zqarkop/NDTControllerAndMonitoring/Image on PDF/Gambar 2.1 Ilustrasi Prinsip Kerja Sensor ECT.png

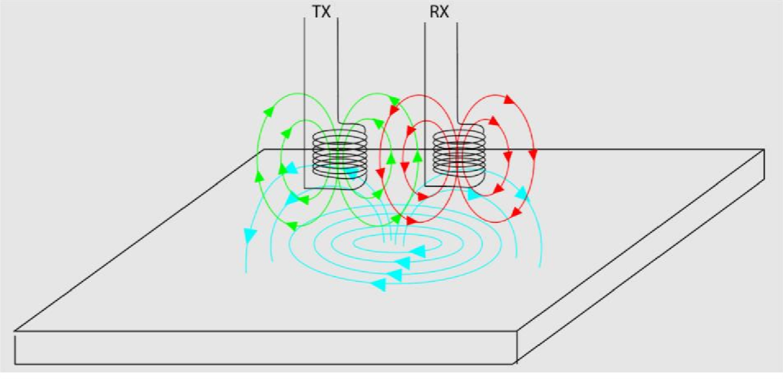
Image on PDF/Gambar 2.1 Ilustrasi Prinsip Kerja Sensor ECT.png
