zqarkop/NDTControllerAndMonitoring/Image on PDF/Gambar 2.2 Ilustrasi Arus Eddy Terhadap Crack.png

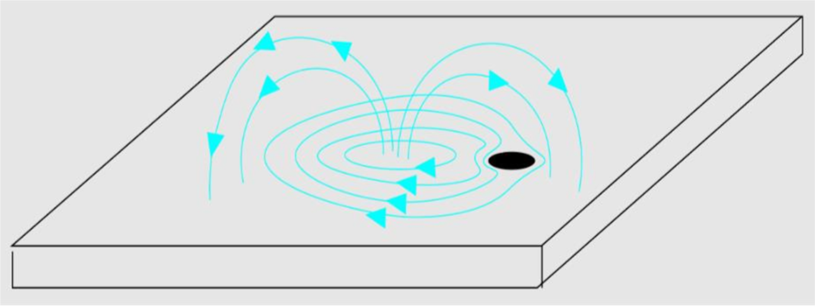
Image on PDF/Gambar 2.2 Ilustrasi Arus Eddy Terhadap Crack.png
