zqarkop/NDTControllerAndMonitoring/Image on PDF/Gambar 2.3 Jenis Filter .png

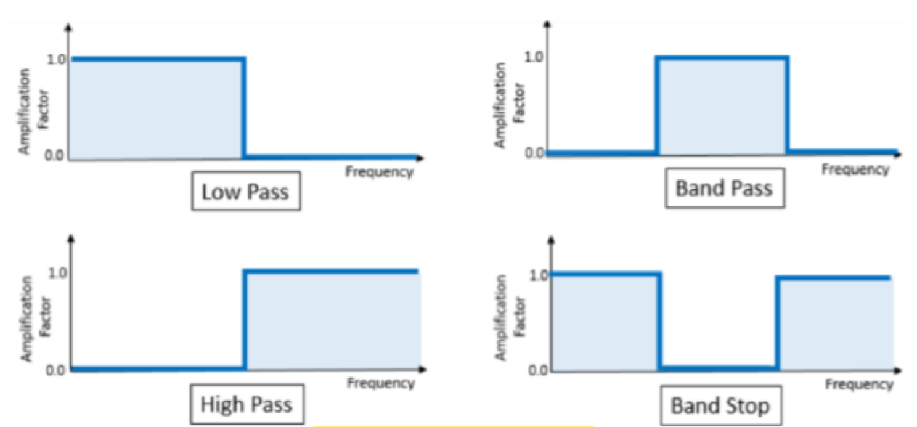
Image on PDF/Gambar 2.3 Jenis Filter .png
