zqarkop/NDTControllerAndMonitoring/Image on PDF/Gambar 2.4 Frequency Response Low Pass Filter .png

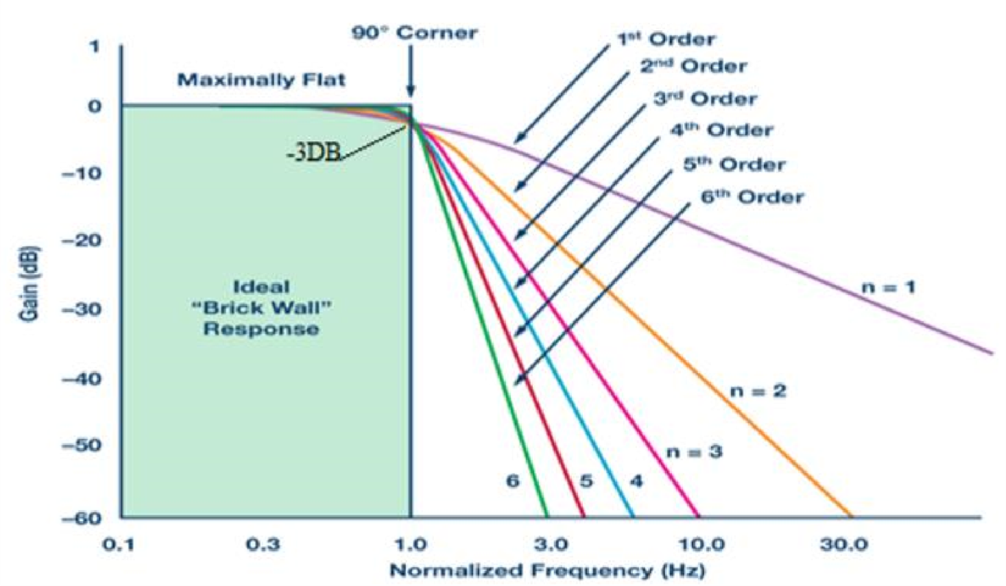
Image on PDF/Gambar 2.4 Frequency Response Low Pass Filter .png
