zqarkop/NDTControllerAndMonitoring/Image on PDF/Gambar 2.5 Topology Sallen Key Filter .png

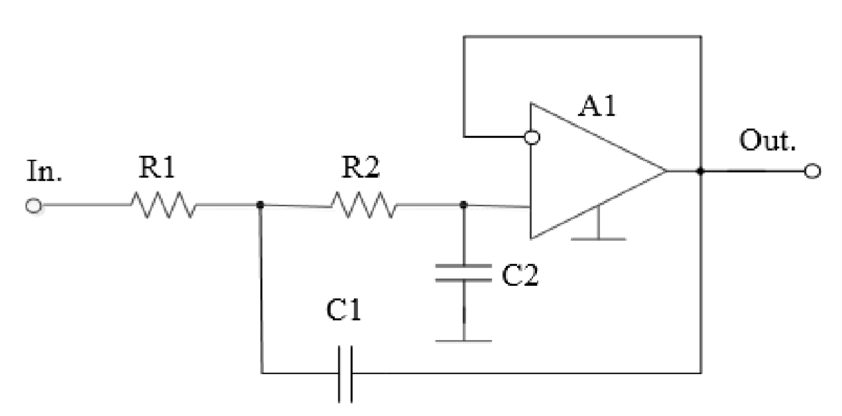
Image on PDF/Gambar 2.5 Topology Sallen Key Filter .png
