zqarkop/NDTControllerAndMonitoring/Image on PDF/Gambar 2.6 Rangkaian Non-Inverting Amplifier .png

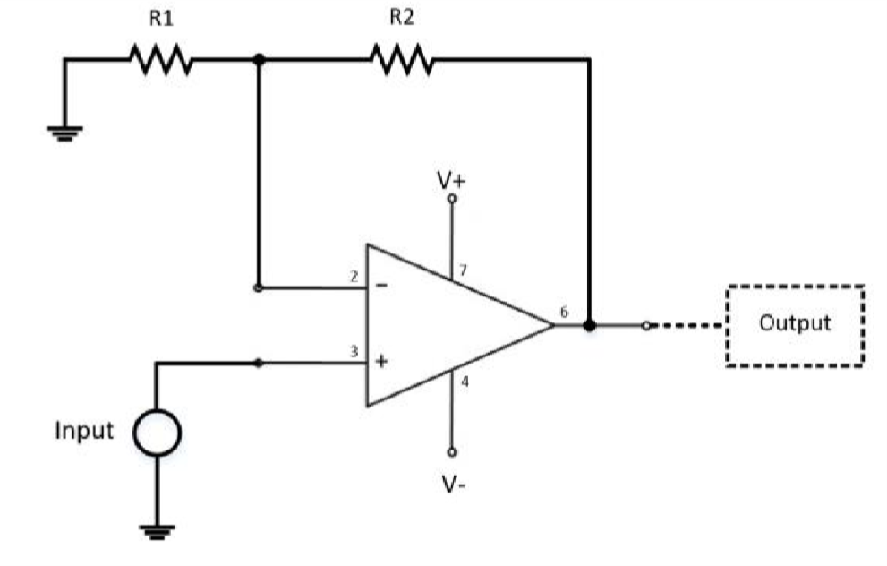
Image on PDF/Gambar 2.6 Rangkaian Non-Inverting Amplifier .png
