zqarkop/NDTControllerAndMonitoring/Image on PDF/Gambar 2.7 Rangkaian Stepper Motor.png

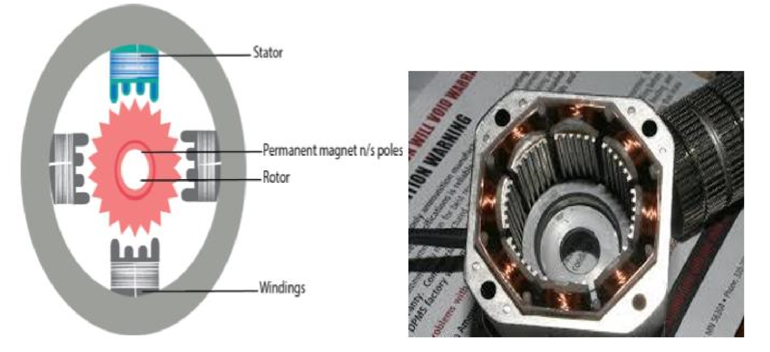
Image on PDF/Gambar 2.7 Rangkaian Stepper Motor.png
