zqarkop/NDTControllerAndMonitoring/Image on PDF/Gambar 3.2 Diagram Skematik Signal Generator Mini .png

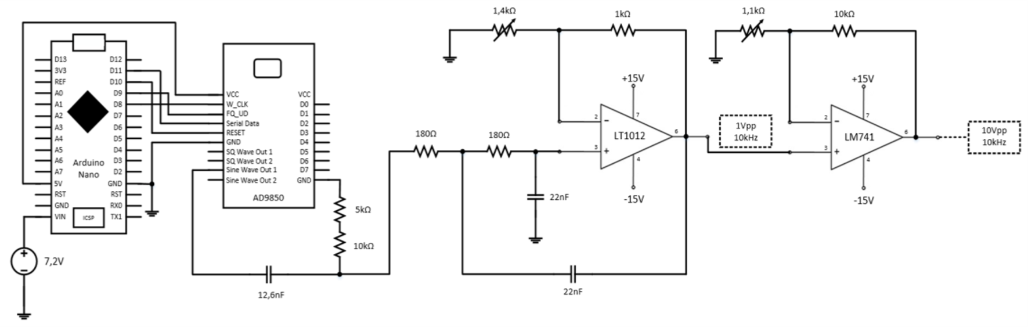
Image on PDF/Gambar 3.2 Diagram Skematik Signal Generator Mini .png
