zqarkop/NDTControllerAndMonitoring/Image on PDF/Gambar 4.2 Keluaran Signal Generator Sine Wave .png

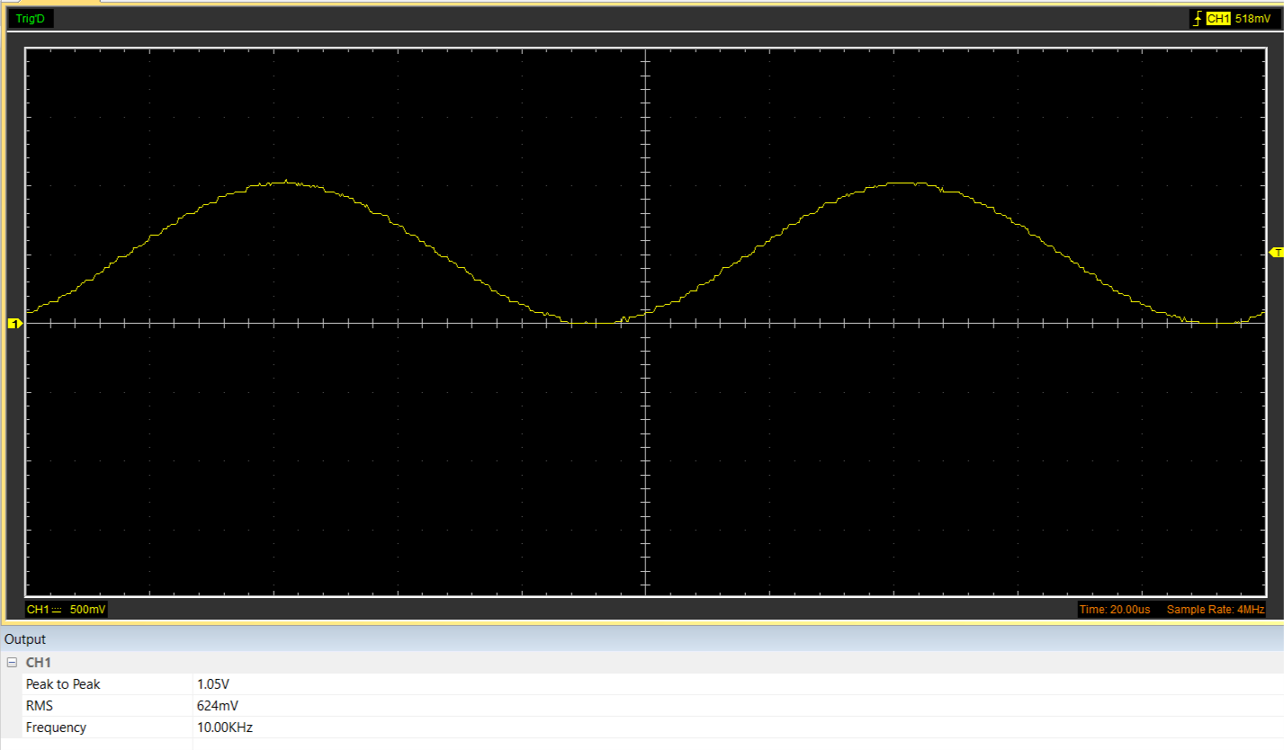
Image on PDF/Gambar 4.2 Keluaran Signal Generator Sine Wave .png
