zqarkop/NDTControllerAndMonitoring/Image on PDF/Gambar 4.4 Diagram Bode HPF dengan Fc 842Hz .png

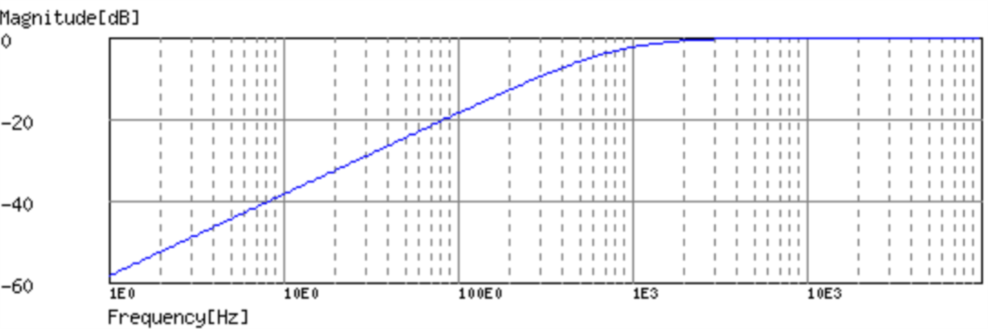
Image on PDF/Gambar 4.4 Diagram Bode HPF dengan Fc 842Hz .png
