zqarkop/NDTControllerAndMonitoring/Image on PDF/Gambar 4.5 Keluaran Signal Generator Setelah Diberi HPF .png

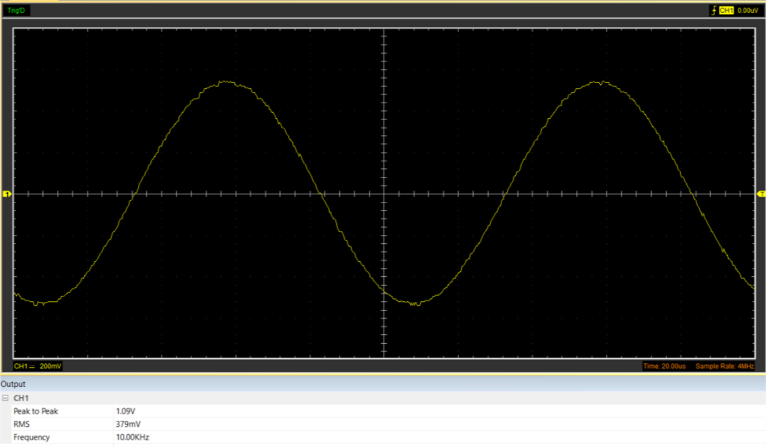
Image on PDF/Gambar 4.5 Keluaran Signal Generator Setelah Diberi HPF .png
