zqarkop/NDTControllerAndMonitoring/Image on PDF/Gambar 4.6 Rangkaian Signal Generator dengan HPF Dan LPF .png

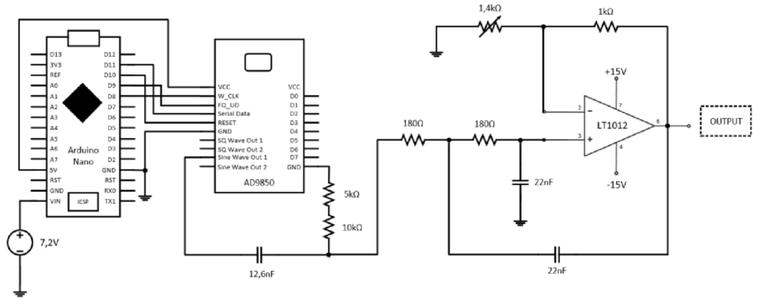
Image on PDF/Gambar 4.6 Rangkaian Signal Generator dengan HPF Dan LPF .png
