zqarkop/NDTControllerAndMonitoring/Image on PDF/Gambar 4.7 Diagram Bode LPF dengan Fc 40,19kHz .png

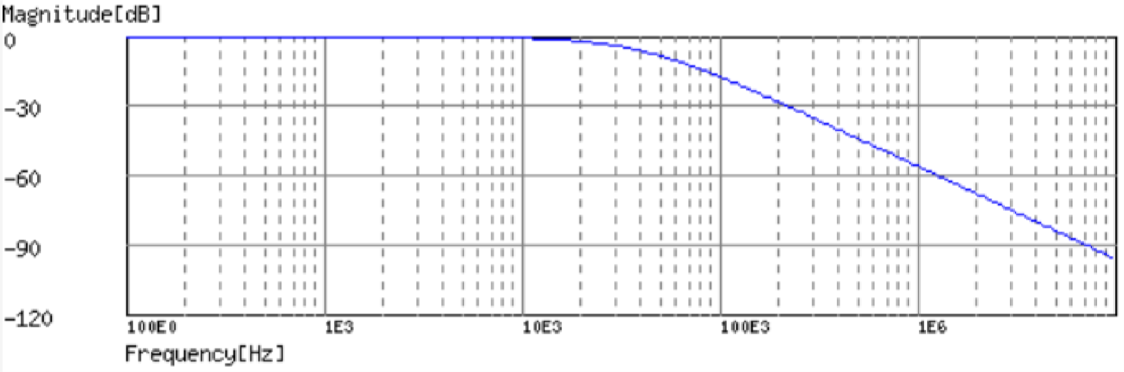
Image on PDF/Gambar 4.7 Diagram Bode LPF dengan Fc 40,19kHz .png
