zqarkop/NDTControllerAndMonitoring/Image on PDF/Gambar 4.9 Keluaran Signal Generator dengan IC LM74.png

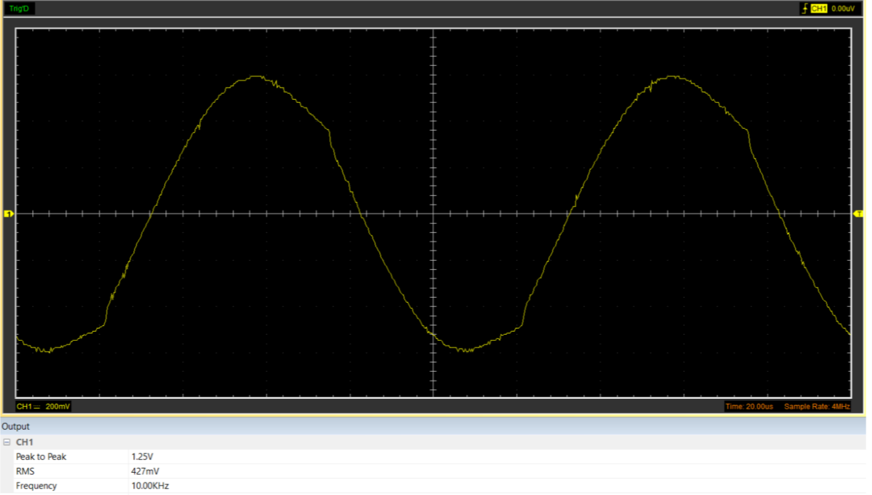
Image on PDF/Gambar 4.9 Keluaran Signal Generator dengan IC LM74.png
