zqarkop/NDTControllerAndMonitoring/Image on PDF/Gambar 4.11 Keluaran Signal Generator Setelah Diperkuat .png

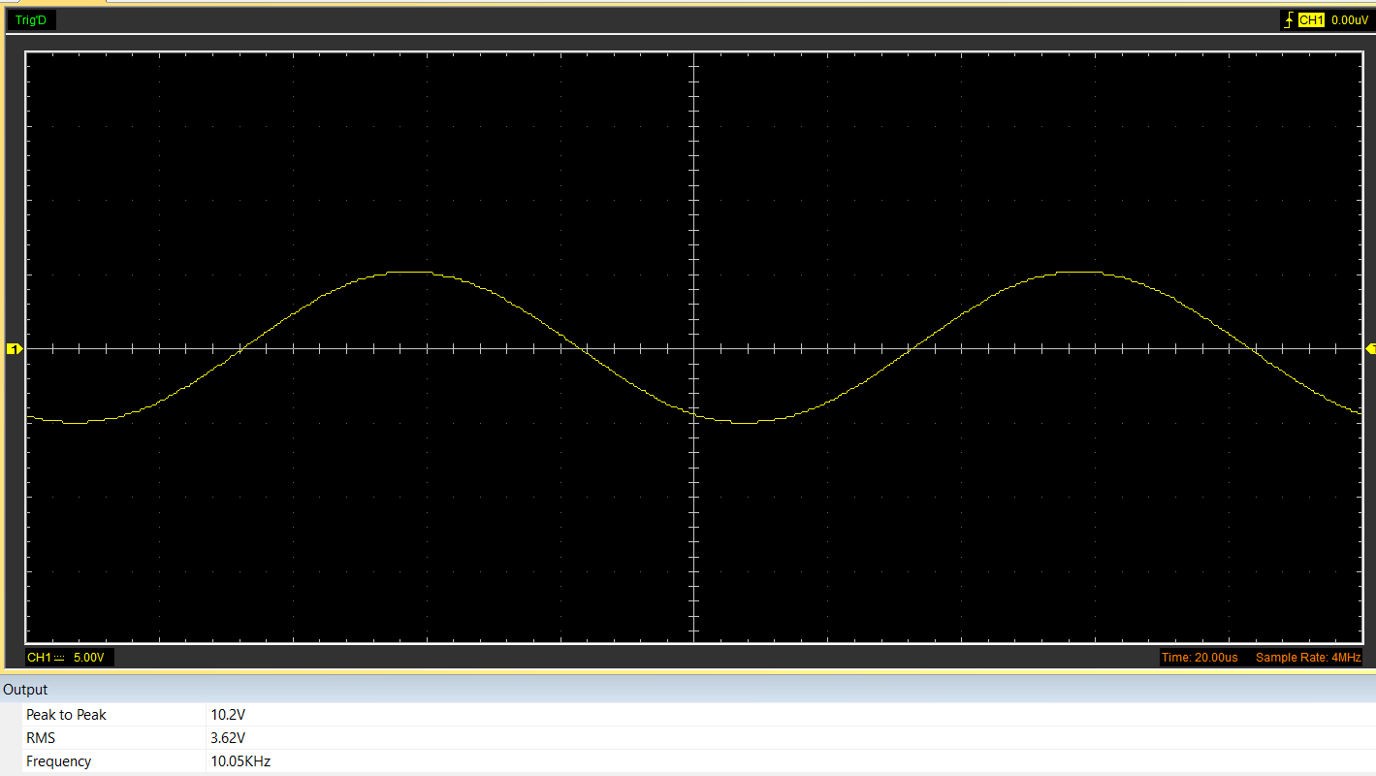
Image on PDF/Gambar 4.11 Keluaran Signal Generator Setelah Diperkuat .png
