zqarkop/NDTControllerAndMonitoring/Image on PDF/Gambar 4.12 Keluaran Signal Generator Menggunakan IC LT1012 .png

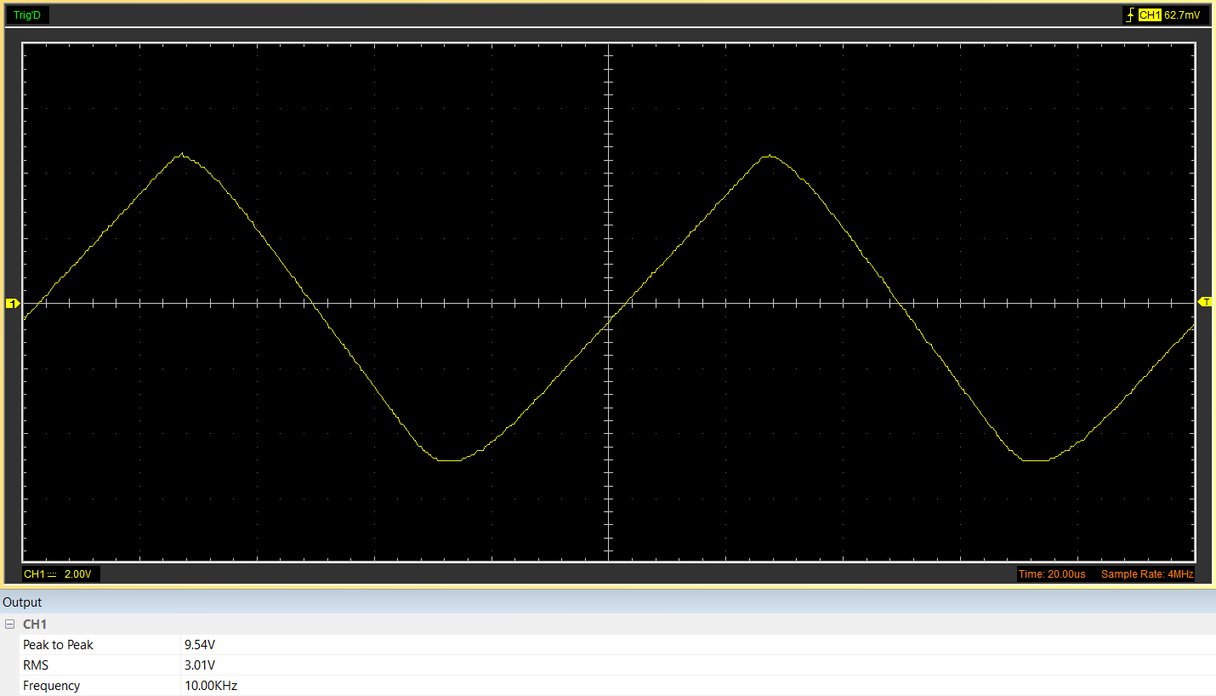
Image on PDF/Gambar 4.12 Keluaran Signal Generator Menggunakan IC LT1012 .png
