zqarkop/NDTControllerAndMonitoring/Image on PDF/Gambar 4.13 Bentuk Keluaran Signal Generator Setelah Diberikan Beban .png

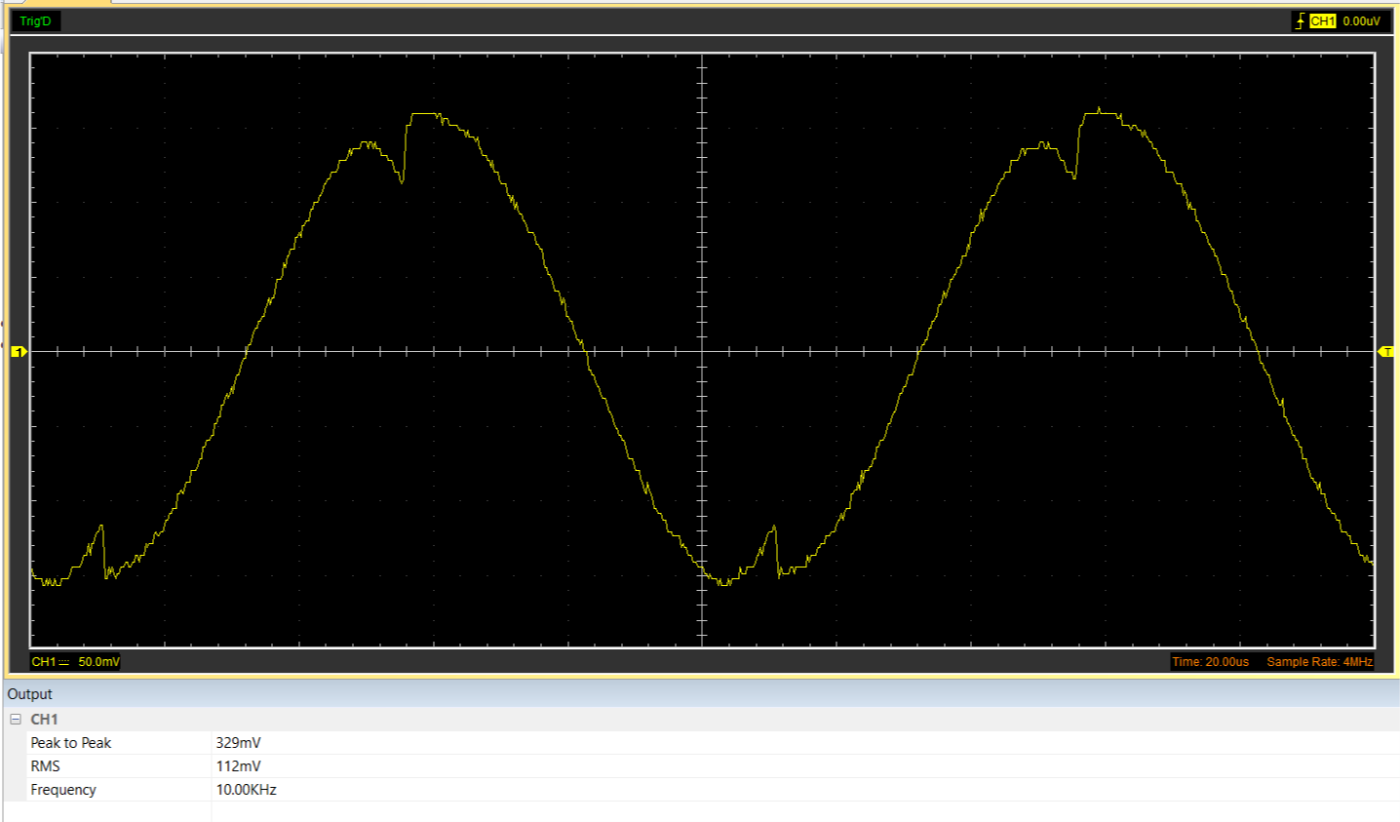
Image on PDF/Gambar 4.13 Bentuk Keluaran Signal Generator Setelah Diberikan Beban .png
