zqarkop/NDTControllerAndMonitoring/Image on PDF/Gambar 4.17 Keluaran Sinyal dari Kumparan Rx .png

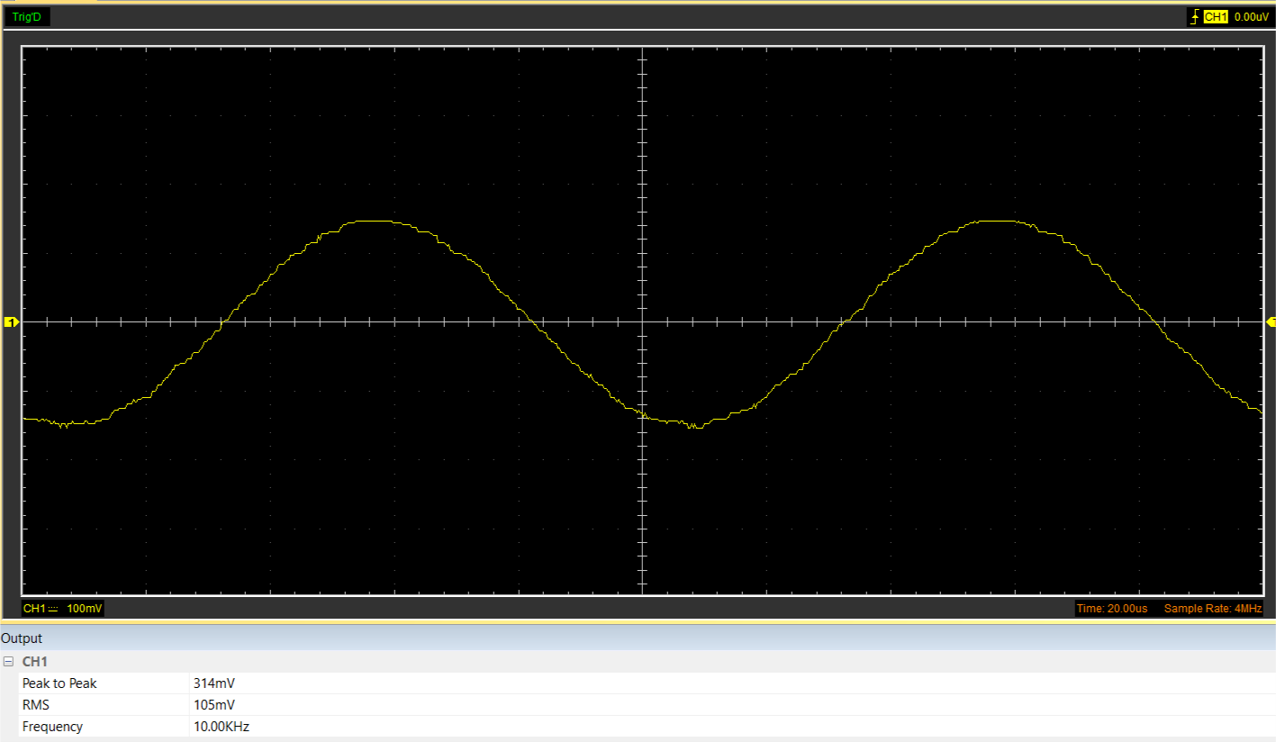
Image on PDF/Gambar 4.17 Keluaran Sinyal dari Kumparan Rx .png
