zqarkop/NDTControllerAndMonitoring/Image on PDF/Gambar 4.22 Bentuk Lubang pada Benda Uji .png

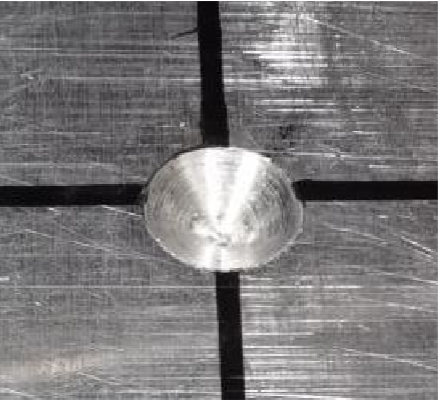
Image on PDF/Gambar 4.22 Bentuk Lubang pada Benda Uji .png
