zqarkop/NDTControllerAndMonitoring/Image on PDF/Gambar 4.23 Grafik Efek Kedalaman Lubang pada Sinyal Kumparan RX.png

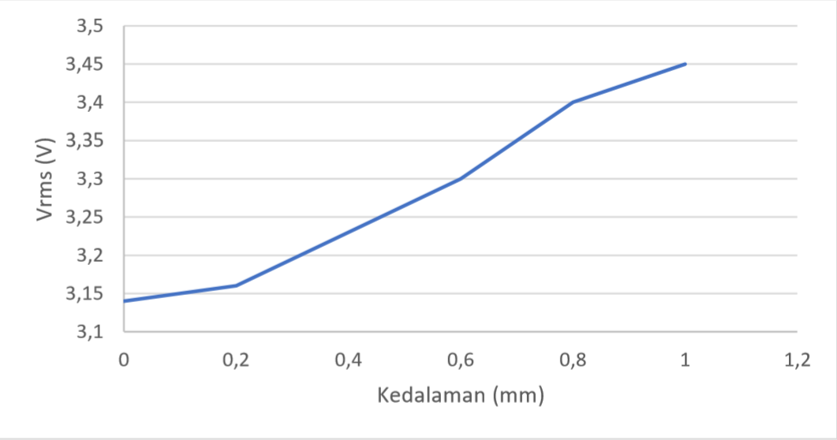
Image on PDF/Gambar 4.23 Grafik Efek Kedalaman Lubang pada Sinyal Kumparan RX.png
