zqarkop/NDTControllerAndMonitoring/Image on PDF/Gambar 4.24 Keluaran Sinyal Tanpa Noise .png

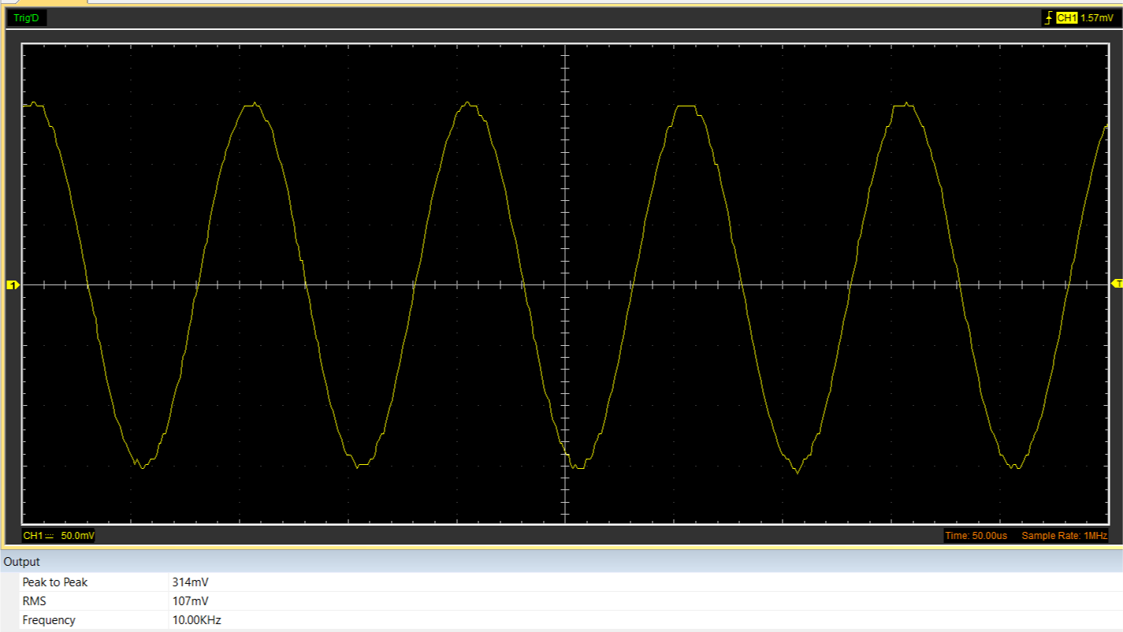
Image on PDF/Gambar 4.24 Keluaran Sinyal Tanpa Noise .png
