zqarkop/NDTControllerAndMonitoring/Image on PDF/Gambar 4.25 Keluaran Sinyal dengan Noise .png

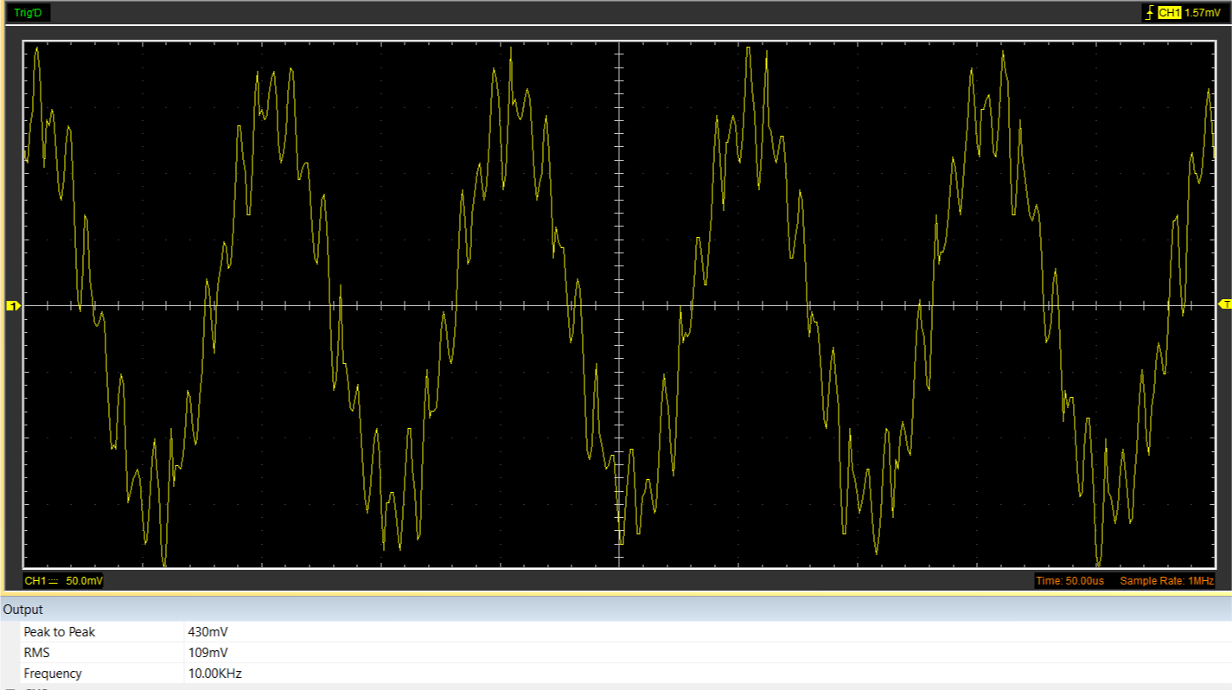
Image on PDF/Gambar 4.25 Keluaran Sinyal dengan Noise .png
