zqarkop/NDTControllerAndMonitoring/Image on PDF/Gambar 4.26 Sinyal Ber-noise dengan FFT .png

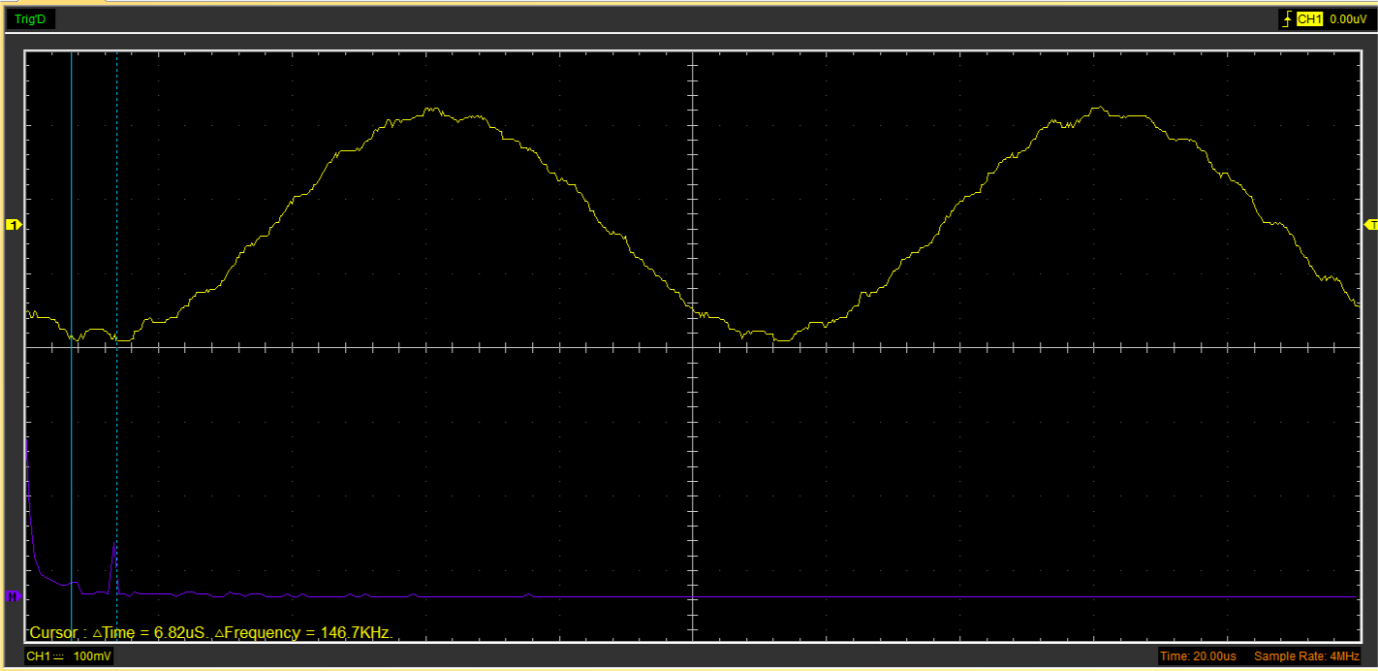
Image on PDF/Gambar 4.26 Sinyal Ber-noise dengan FFT .png
