zqarkop/NDTControllerAndMonitoring/Image on PDF/Gambar 4.27 Penguat Tegangan Rx Setelah Diberi Low Pass Filter .png

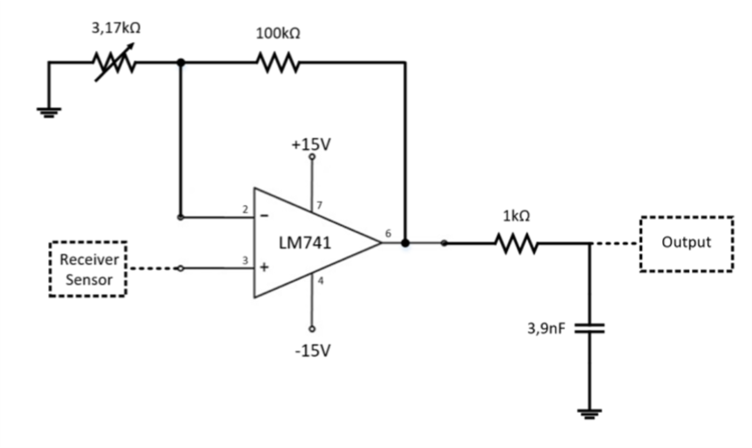
Image on PDF/Gambar 4.27 Penguat Tegangan Rx Setelah Diberi Low Pass Filter .png
