zqarkop/NDTControllerAndMonitoring/Image on PDF/Gambar 4.28 Diagram Bode Low Pass Filter dengan Fc 40kHz .png

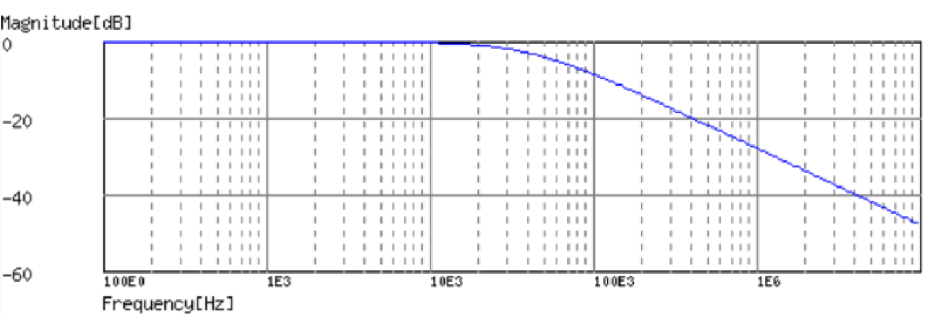
Image on PDF/Gambar 4.28 Diagram Bode Low Pass Filter dengan Fc 40kHz .png
