zqarkop/NDTControllerAndMonitoring/Image on PDF/Gambar 4.29 Keluaran Sinyal Ber-noise Sesudah dan Sebelum Diberi Filter .png

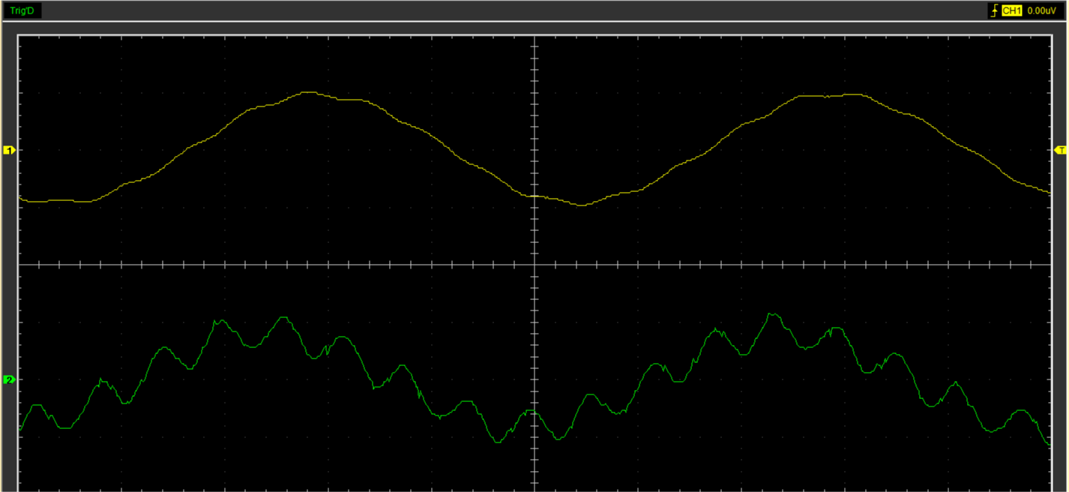
Image on PDF/Gambar 4.29 Keluaran Sinyal Ber-noise Sesudah dan Sebelum Diberi Filter .png
