zqarkop/NDTControllerAndMonitoring/Image on PDF/Gambar 4.30 Digital Osciloscope dengan Visual Basic 6.0 .png

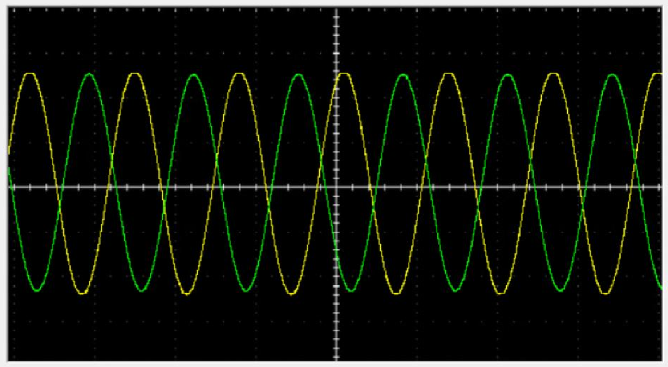
Image on PDF/Gambar 4.30 Digital Osciloscope dengan Visual Basic 6.0 .png
