zqarkop/NDTControllerAndMonitoring/Image on PDF/Gambar 4.36 Form Masukan Dimensi Benda Uji .png

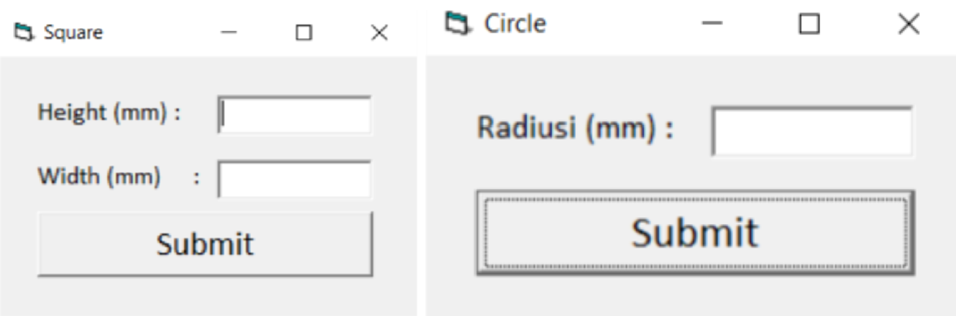
Image on PDF/Gambar 4.36 Form Masukan Dimensi Benda Uji .png
