zqarkop/NDTControllerAndMonitoring/Image on PDF/Gambar 4.38 Contour Plot Hasil Pengujian .png

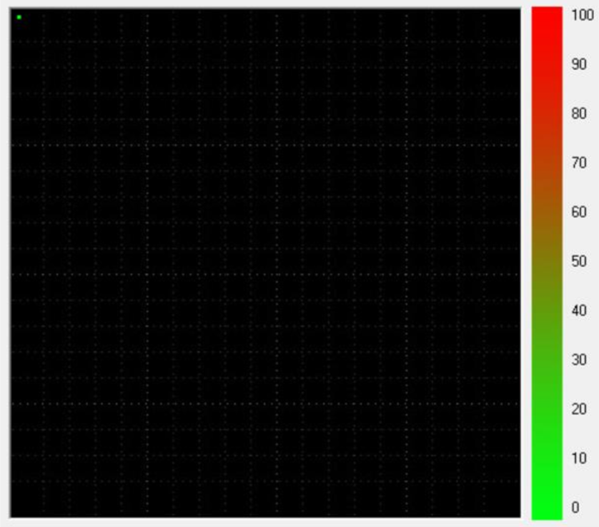
Image on PDF/Gambar 4.38 Contour Plot Hasil Pengujian .png
