zqarkop/NDTControllerAndMonitoring/Image on PDF/Gambar 4.39 Contour Plot Dari Hasil Pengujian Benda Uji 18cm x 18cm .png

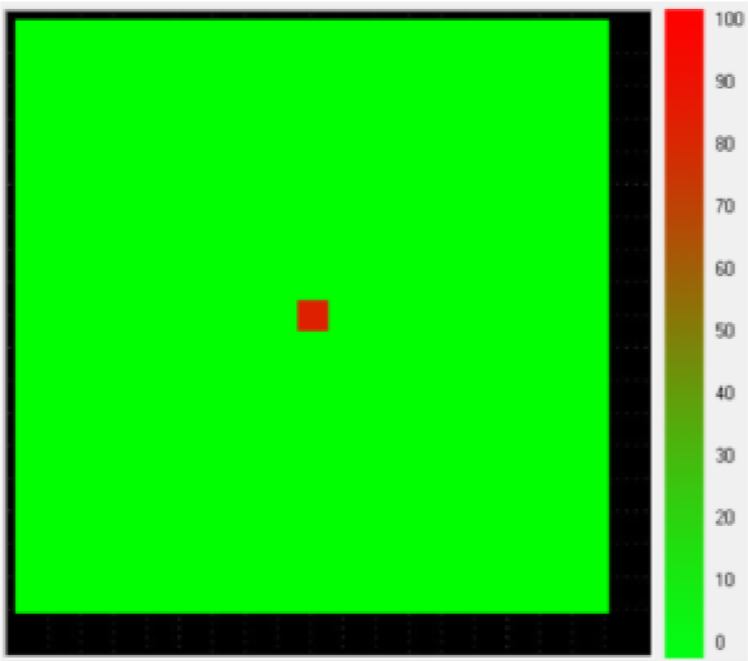
Image on PDF/Gambar 4.39 Contour Plot Dari Hasil Pengujian Benda Uji 18cm x 18cm .png
