zqarkop/NDTControllerAndMonitoring/Image on PDF/Gambar 4.40 Benda Uji dengan Satu Lubang Ditengah .jpg

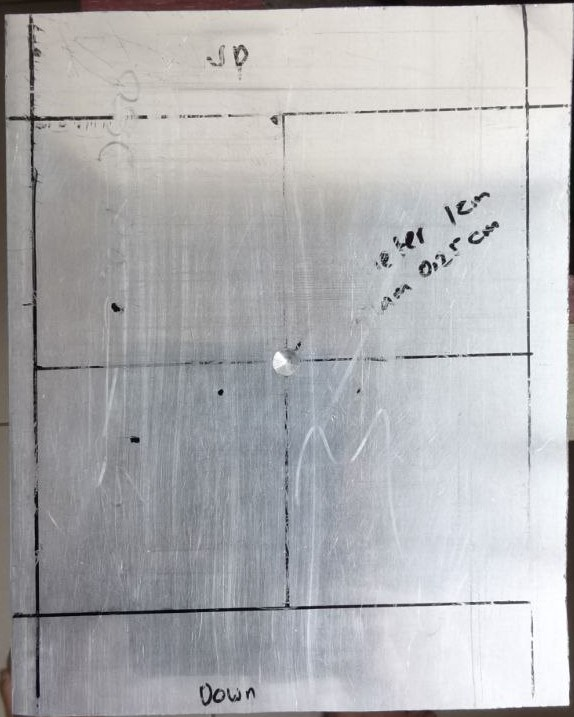
Image on PDF/Gambar 4.40 Benda Uji dengan Satu Lubang Ditengah .jpg
