zqarkop/NDTControllerAndMonitoring/Image on PDF/Gambar B.1 Benda Uji Lubang Pinggir.jpg

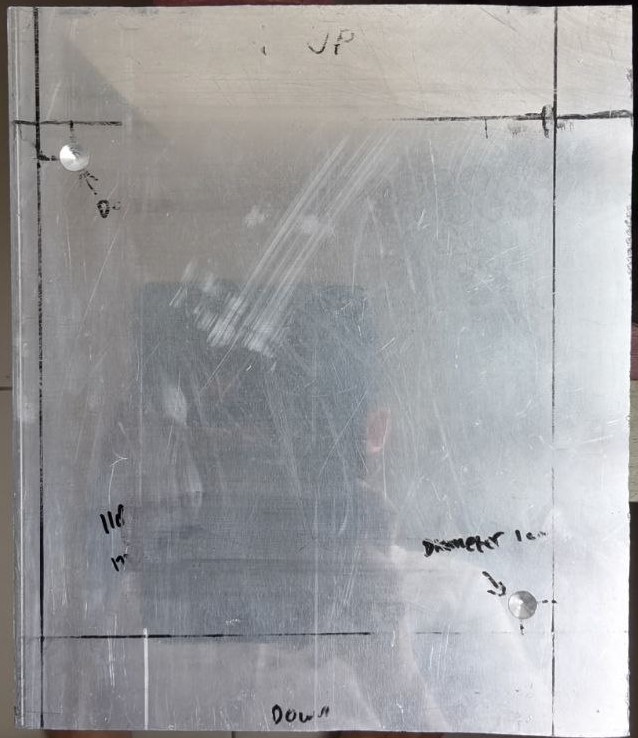
Image on PDF/Gambar B.1 Benda Uji Lubang Pinggir.jpg
