zqarkop/NDTControllerAndMonitoring/Image on PDF/Gambar B.3 Benda Uji Tanpa Lubang .jpg

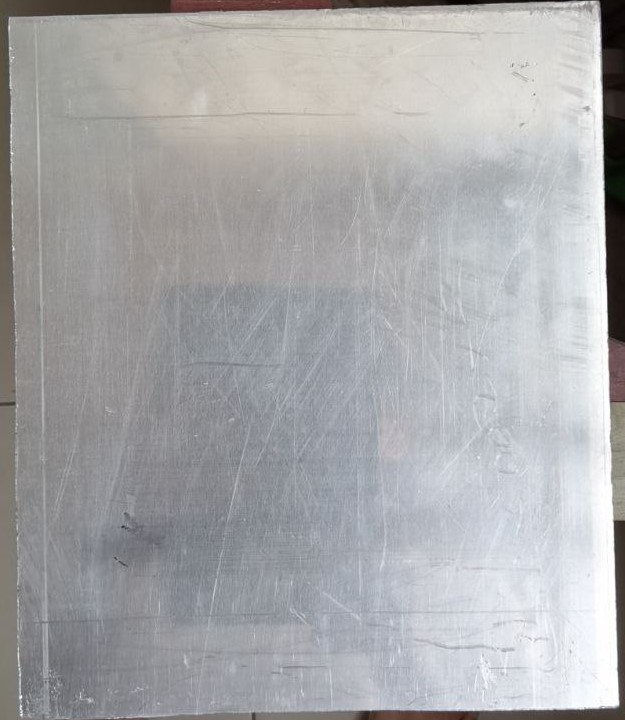
Image on PDF/Gambar B.3 Benda Uji Tanpa Lubang .jpg
