zqarkop/NDTControllerAndMonitoring/Image on PDF/Gambar B.4 Proses Scanning Benda Uji (Hardware) .png

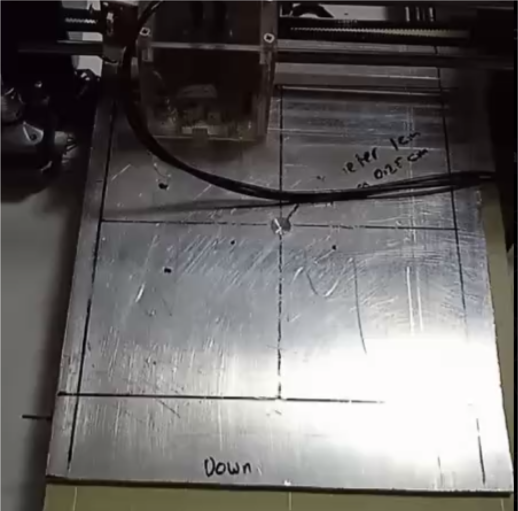
Image on PDF/Gambar B.4 Proses Scanning Benda Uji (Hardware) .png
