zqarkop/NDTControllerAndMonitoring/Image on PDF/Gambar B.8 Hasil Pengujian Lubang Tengah Langkah 1cm .png

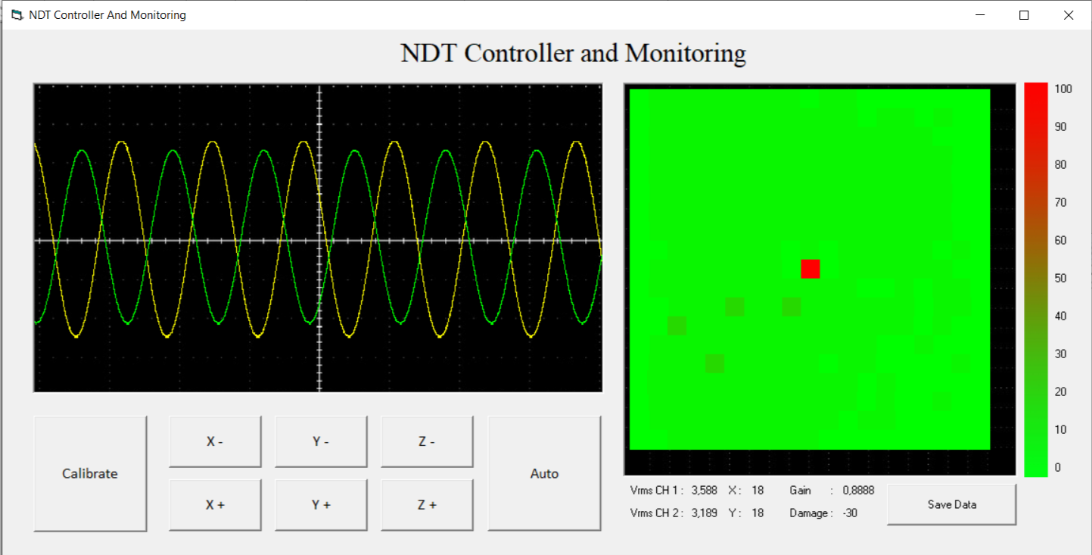
Image on PDF/Gambar B.8 Hasil Pengujian Lubang Tengah Langkah 1cm .png
