zqarkop/NDTControllerAndMonitoring/Image on PDF/Gambar B.9 Hasil Pengujian Lubang Tengah Langkah 1mm .png

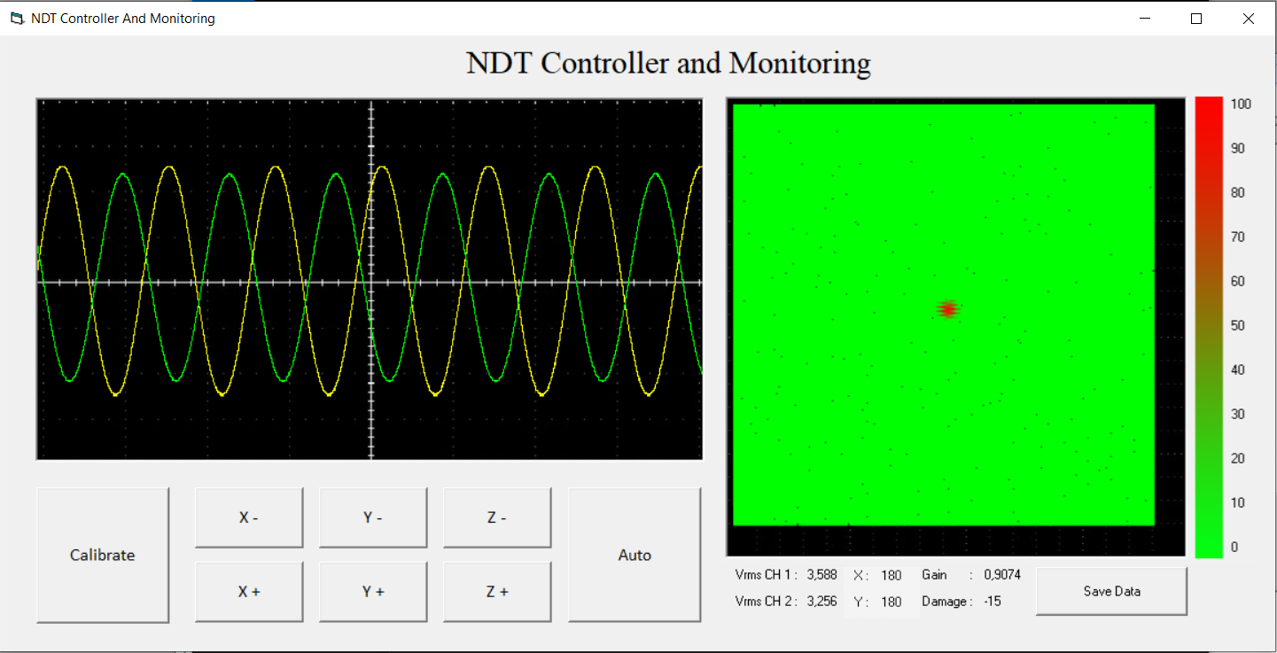
Image on PDF/Gambar B.9 Hasil Pengujian Lubang Tengah Langkah 1mm .png
