zqarkop/NDTControllerAndMonitoring/Image on PDF/Gambar B.10 Hasil Pengujian Tanpa Lubang Langkah 1cm .png

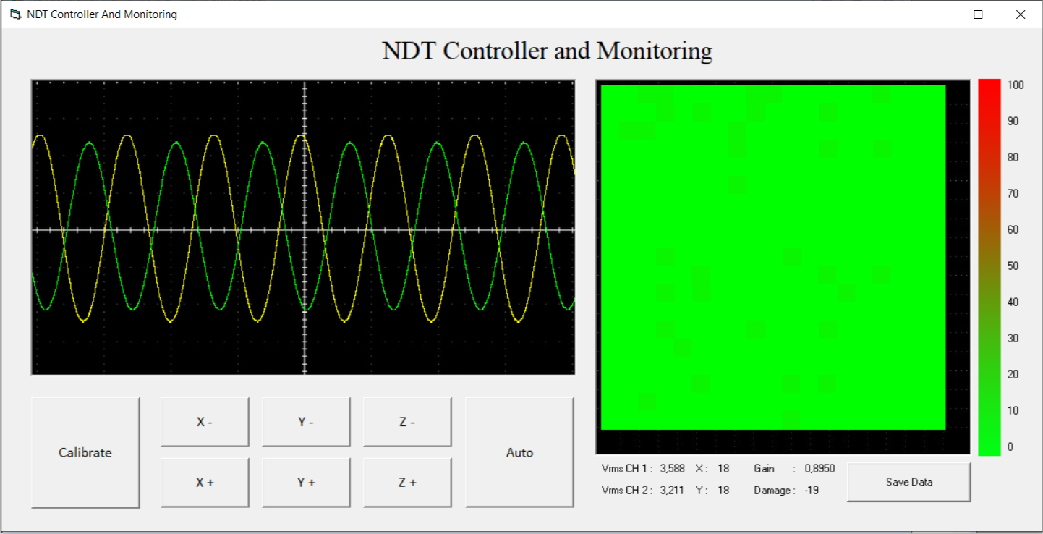
Image on PDF/Gambar B.10 Hasil Pengujian Tanpa Lubang Langkah 1cm .png
