zqarkop/NDTControllerAndMonitoring/Image on PDF/Gambar B.12 Hasil Pengujian Lubang Tengah Geometri Lingkaran .png

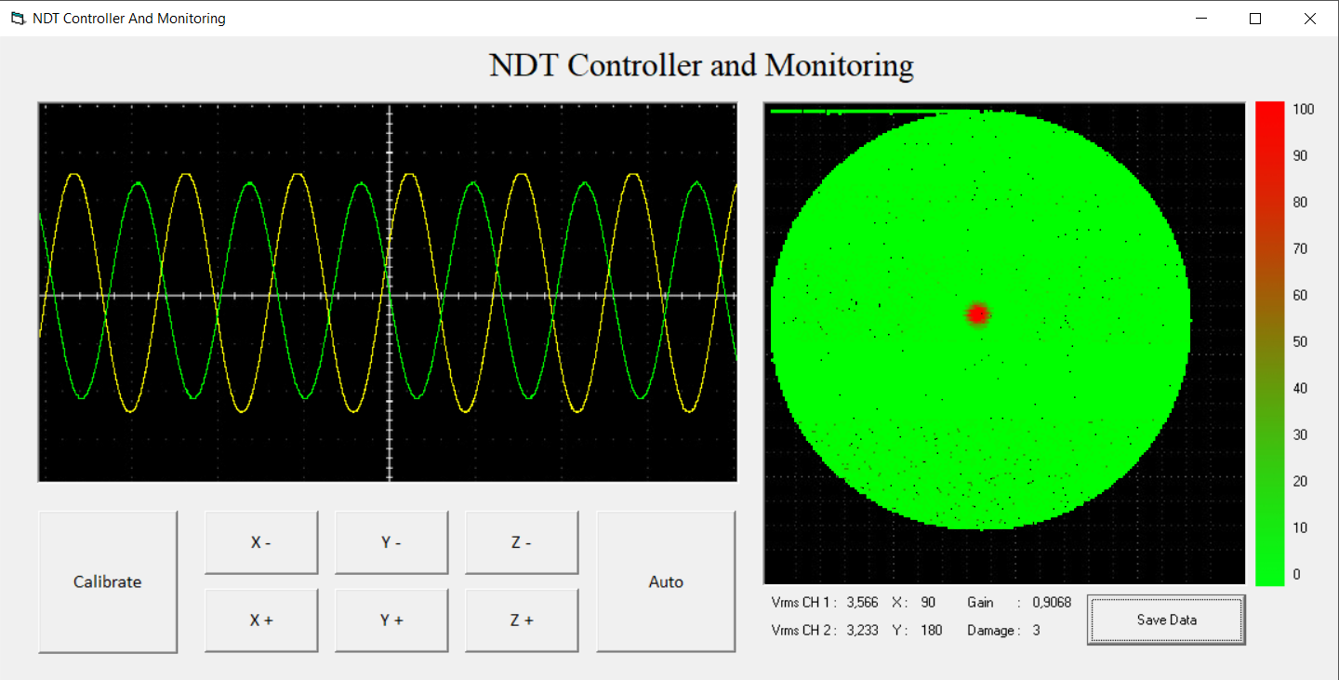
Image on PDF/Gambar B.12 Hasil Pengujian Lubang Tengah Geometri Lingkaran .png
