zqarkop/NDTControllerAndMonitoring/Project VB/bgDisplay.jpg

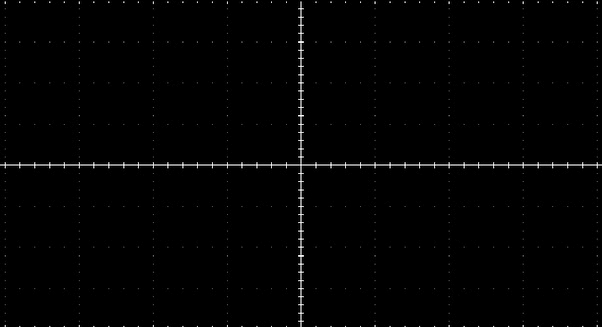
Project VB/bgDisplay.jpg
