zqarkop/NDTControllerAndMonitoring/Project VB/ColorBar.jpg

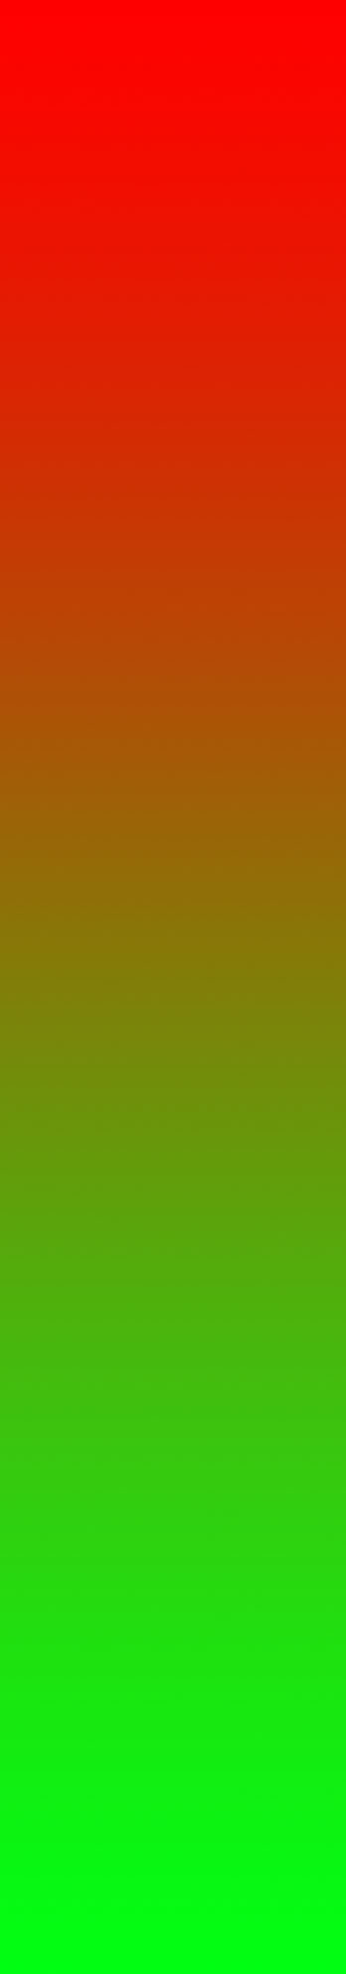
Project VB/ColorBar.jpg
