zqarkop/NDTControllerAndMonitoring/Project VB/Mentahan Background.jpg

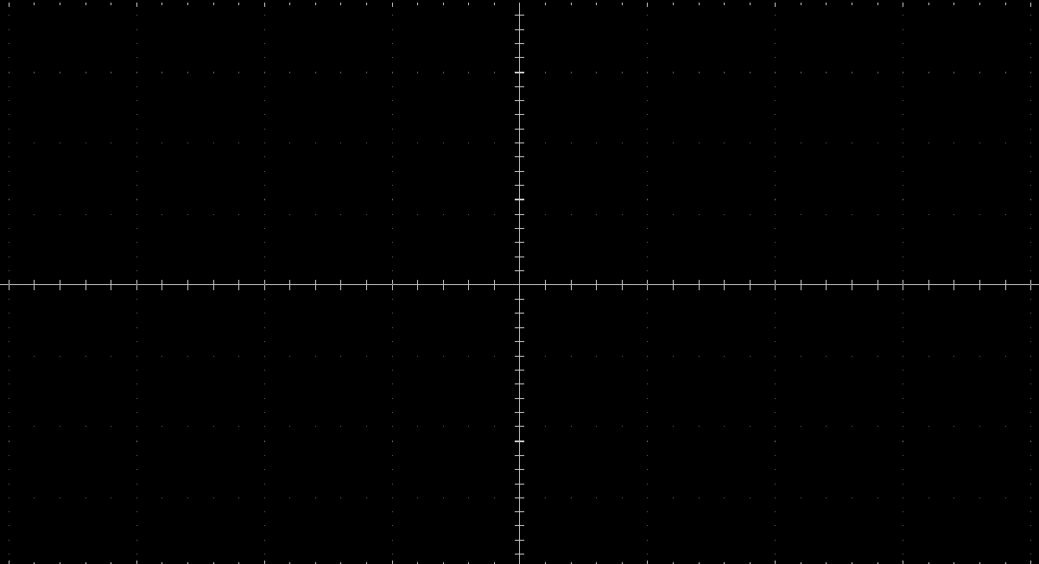
Project VB/Mentahan Background.jpg
