zqarkop/NDTControllerAndMonitoring/Data Testing/Koefisien korelasi/Result.txt

Lubang Tengah 
Manual 0.67 
Auto   0.76

Lubang Pinggir 
Manual 0.57 
Auto   0.65
