zqarkop/NDTControllerAndMonitoring/Data Testing/Koefisien korelasi/Lubang pinggir auto.csv

X | Y | Vtx | Vrx | Gain | Kondisi Real | Kondisi Seharusnya
0 | 0 | 3,566203598 | 3,189647938 | 0,894409938 | 0 | 0
1 | 0 | 3,588353931 | 3,189647938 | 0,888888889 | 0 | 0
2 | 0 | 3,566203598 | 3,189647938 | 0,894409938 | 0 | 0
3 | 0 | 3,566203598 | 3,211798271 | 0,900621118 | 0 | 0 | Coef | 0,654668242
4 | 0 | 3,588353931 | 3,211798271 | 0,895061728 | 0 | 0
5 | 0 | 3,566203598 | 3,211798271 | 0,900621118 | 0 | 0
6 | 0 | 3,566203598 | 3,211798271 | 0,900621118 | 0 | 0
7 | 0 | 3,566203598 | 3,211798271 | 0,900621118 | 0 | 0
8 | 0 | 3,588353931 | 3,211798271 | 0,895061728 | 0 | 0
9 | 0 | 3,588353931 | 3,211798271 | 0,895061728 | 0 | 0
10 | 0 | 3,588353931 | 3,233948604 | 0,901234568 | 0 | 0
11 | 0 | 3,588353931 | 3,233948604 | 0,901234568 | 0 | 0
12 | 0 | 3,588353931 | 3,233948604 | 0,901234568 | 0 | 0
13 | 0 | 3,566203598 | 3,211798271 | 0,900621118 | 0 | 0
14 | 0 | 3,588353931 | 3,233948604 | 0,901234568 | 0 | 0
15 | 0 | 3,566203598 | 3,233948604 | 0,906832298 | 0 | 0
16 | 0 | 3,566203598 | 3,211798271 | 0,900621118 | 0 | 0
17 | 0 | 3,566203598 | 3,211798271 | 0,900621118 | 0 | 0
18 | 0 | 3,588353931 | 3,256098937 | 0,907407407 | 0 | 0
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
