zqarkop/NDTControllerAndMonitoring/Data Testing/Koefisien korelasi/Lubang tengah auto.csv

X | Y | Vtx | Vrx | Gain | Kondisi Real | Kondisi Seharusnya
0 | 0 | 3,588353931 | 3,233948604 | 0,901234568 | 0 | 0
1 | 0 | 3,588353931 | 3,256098937 | 0,907407407 | 0 | 0
2 | 0 | 3,588353931 | 3,256098937 | 0,907407407 | 0 | 0
3 | 0 | 3,588353931 | 3,256098937 | 0,907407407 | 0 | 0
4 | 0 | 3,588353931 | 3,256098937 | 0,907407407 | 0 | 0
5 | 0 | 3,588353931 | 3,256098937 | 0,907407407 | 0 | 0
6 | 0 | 3,588353931 | 3,256098937 | 0,907407407 | 0 | 0
7 | 0 | 3,610504263 | 3,256098937 | 0,901840491 | 0 | 0
8 | 0 | 3,588353931 | 3,256098937 | 0,907407407 | 0 | 0 | Corr | 0,760664313
9 | 0 | 3,588353931 | 3,256098937 | 0,907407407 | 0 | 0
10 | 0 | 3,588353931 | 3,256098937 | 0,907407407 | 0 | 0
12 | 0 | 3,588353931 | 3,256098937 | 0,907407407 | 0 | 0
13 | 0 | 3,588353931 | 3,256098937 | 0,907407407 | 0 | 0
14 | 0 | 3,588353931 | 3,233948604 | 0,901234568 | 0 | 0
15 | 0 | 3,588353931 | 3,256098937 | 0,907407407 | 0 | 0
16 | 0 | 3,588353931 | 3,256098937 | 0,907407407 | 0 | 0
18 | 0 | 3,588353931 | 3,256098937 | 0,907407407 | 0 | 0
19 | 0 | 3,588353931 | 3,256098937 | 0,907407407 | 0 | 0
20 | 0 | 3,588353931 | 3,256098937 | 0,907407407 | 0 | 0
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
