zqarkop/NDTControllerAndMonitoring/Project VB/bgResult.jpg

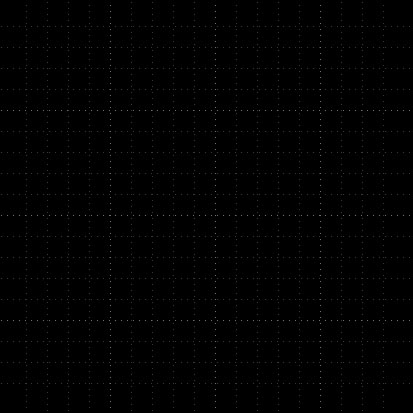
Project VB/bgResult.jpg
